andreamazzai/ml/docs/_docs/en/15-clock-en.md

---
title: "Clock"
permalink: en/docs/clock/
excerpt: "Clock Module of the BEAM computer"
---
<small>[Loader and Clock](#loader-and-clock) - [Schematics](#schematics) - [The HLT Instruction](#the-hlt-instruction) - [Useful Links](#useful-links)</small>

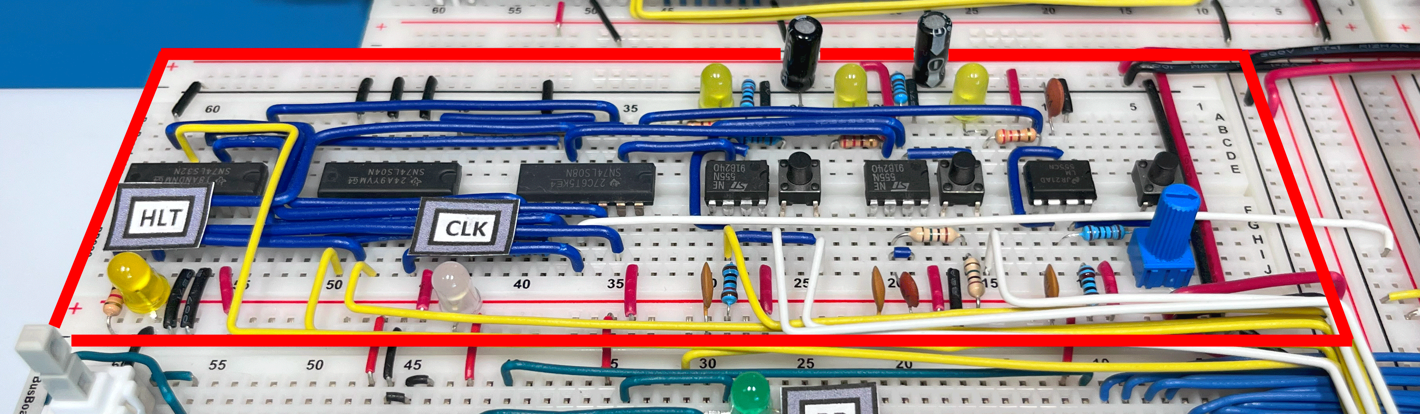
[picture p6: docs/assets/clock/15-beam-clock.png]
BEAM Computer Clock Module


The BEAM computer clock module follows the design created by Ben Eater for the SAP-1 computer, but it uses tactile push buttons instead of slide switches and adds some interaction with external control signals coming from the Loader.

- The first 555 is used as an astable oscillator, with the frequency of operation selectable via a potentiometer. A "Turbo" button temporarily bypasses the potentiometer's resistance, bringing the clock frequency to its maximum value. When running low-speed clock programs for visual analysis of outputs, this button acts like a "Fast Forward."
- The second 555 in monostable mode executes individual micro-operations ("Step").
- The third 555 in bistable mode starts and stops the first 555's clock using a convenient "Start/Stop" button, instead of a switch as in the SAP-1 circuit.

Pressing the Step button during normal operation (astable mode) halts the computer at the current microinstruction and allows proceeding in "Step by Step" mode by repeatedly pressing the same button. Pressing the Start/Stop button resumes normal operation with the astable clock.

The Start/Stop and Step buttons have also been duplicated in a more easily accessible area of the computer, specifically under the Control Logic. In this location, a Reset button has also been included.

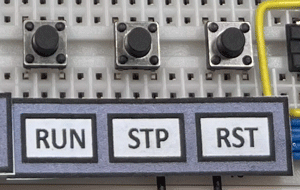
[picture p7: docs/assets/clock/15-run-step-reset.png]
Start/Stop, Step, Reset buttons
[]

### Loader and Clock

On the clock module, there are three signals coming from the [Loader](../en/loader/) based on Arduino: LDR-Active, LDR-CLK, and CLK-Start.

The **LDR-Active** signal, when set to HI, allows the Loader to take control of the clock circuit, completely disabling its output and halting the program execution. In this case, the Loader can inject its clock signal **LDR-CLK** into the computer.

The **CLK-Start** signal is used by the Loader at the end of the programming process to reactivate the clock module and start the freshly loaded program.

## Schematics

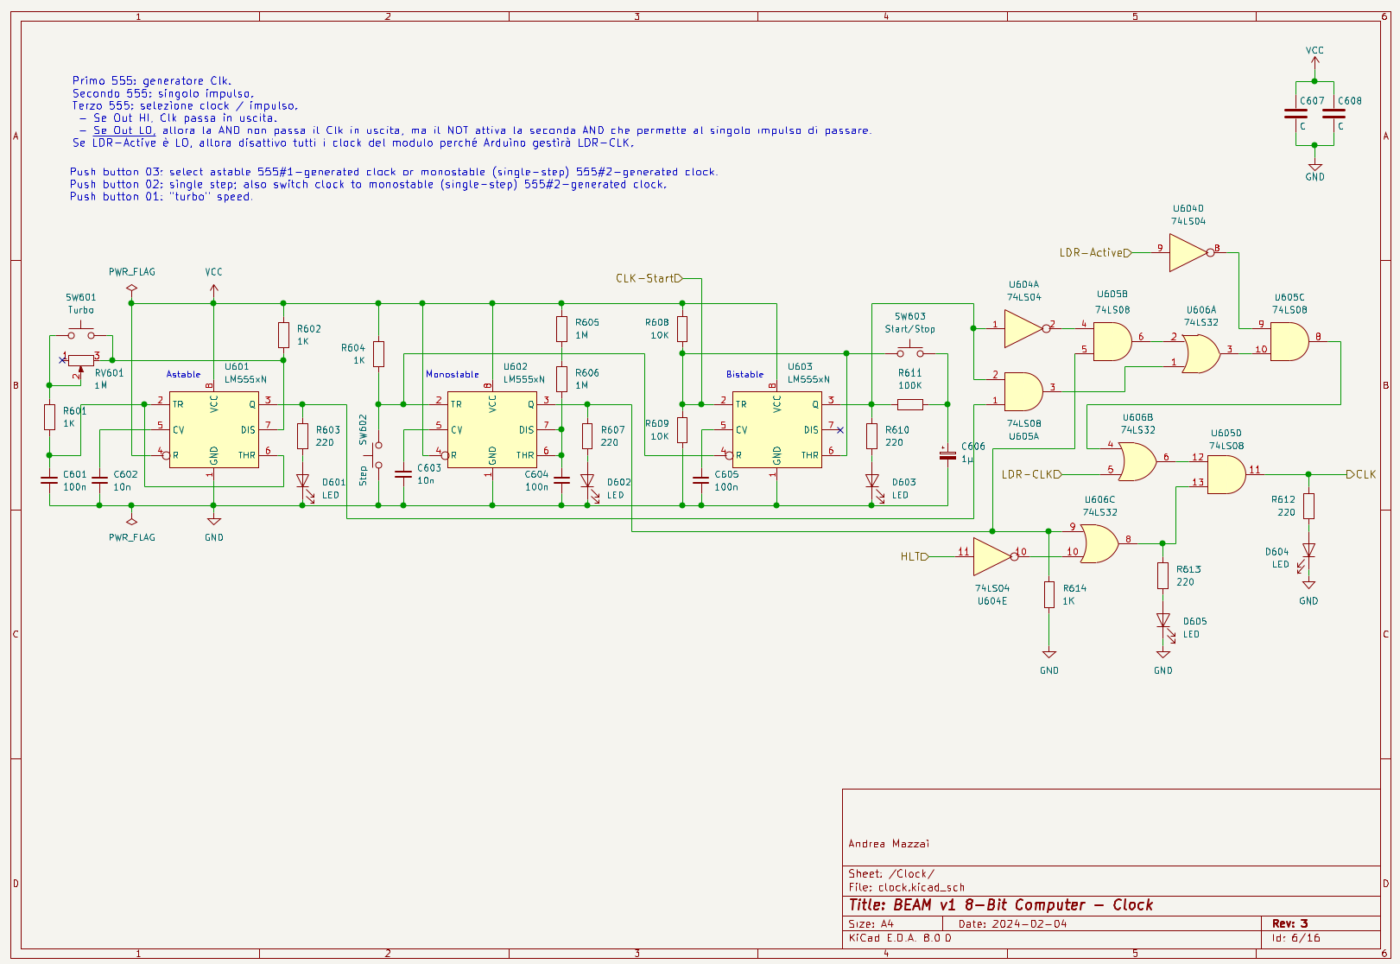
[picture p8: docs/assets/clock/15-clock-schema.png]
Clock Module Schematic


*Clock Module Schematic.*

## The HLT Instruction

The microcode for the HLT instruction activates the corresponding signal on the clock module, halting the execution of the program. To resume operation in continuous clock mode, the current microinstruction must be bypassed by pressing the Step button. At this point, the program execution can be restarted using the Start/Stop button.

## Useful Links

- Ben Eater's <a href="https://eater.net/8bit/clock" target="_blank">videos</a> describing the operation of the 555 timers and the construction of the clock module.
- <a href="https://todbot.com/blog/2010/01/02/momentary-button-as-onoff-toggle-using-555/" target="_blank">A blog</a> explaining how to create a bistable circuit, used here to create the "Start/Stop" function with a button instead of a switch.
