andreamazzai/ml/docs/assets/alu/50-alu-beam-small-top.png

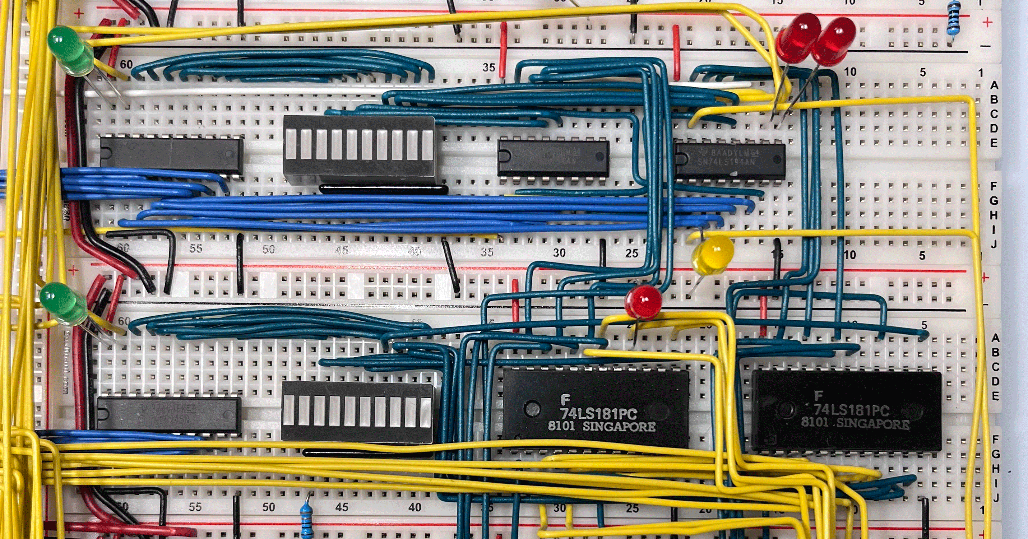
docs/assets/alu/50-alu-beam-small-top.png
