andreamazzai/ml/docs/assets/alu/50-alu-beam-top.png

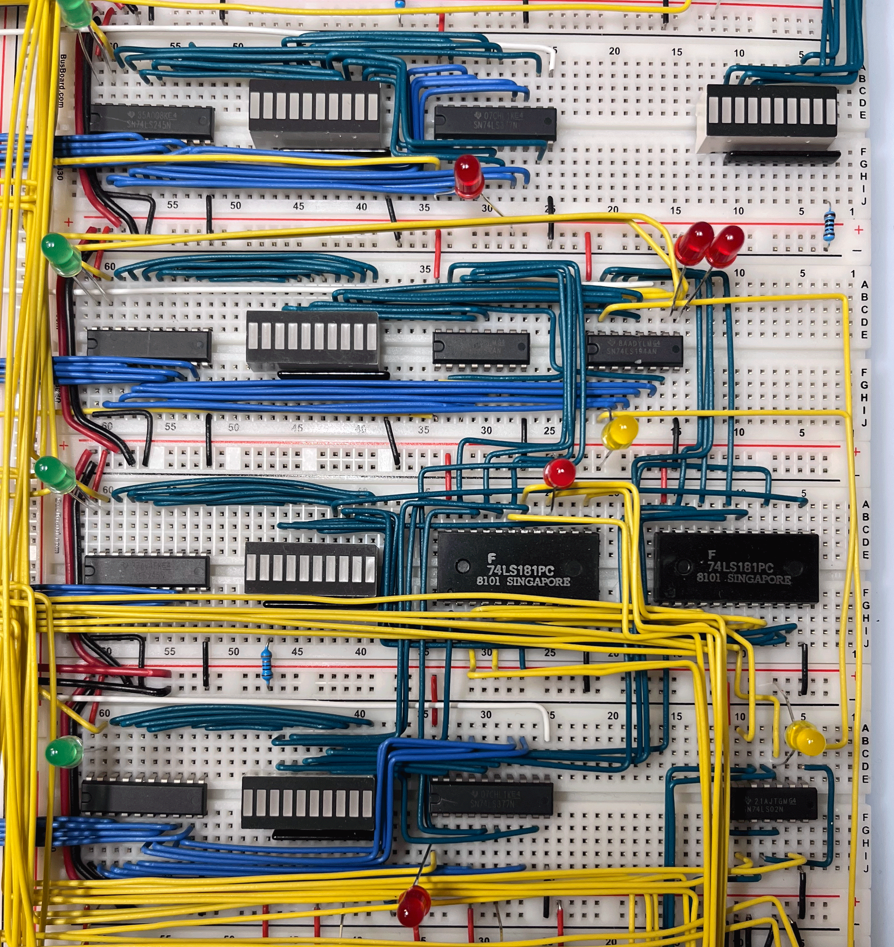
docs/assets/alu/50-alu-beam-top.png
