andreamazzai/ml/docs/assets/control/40-control-logic-161-138-beam.png

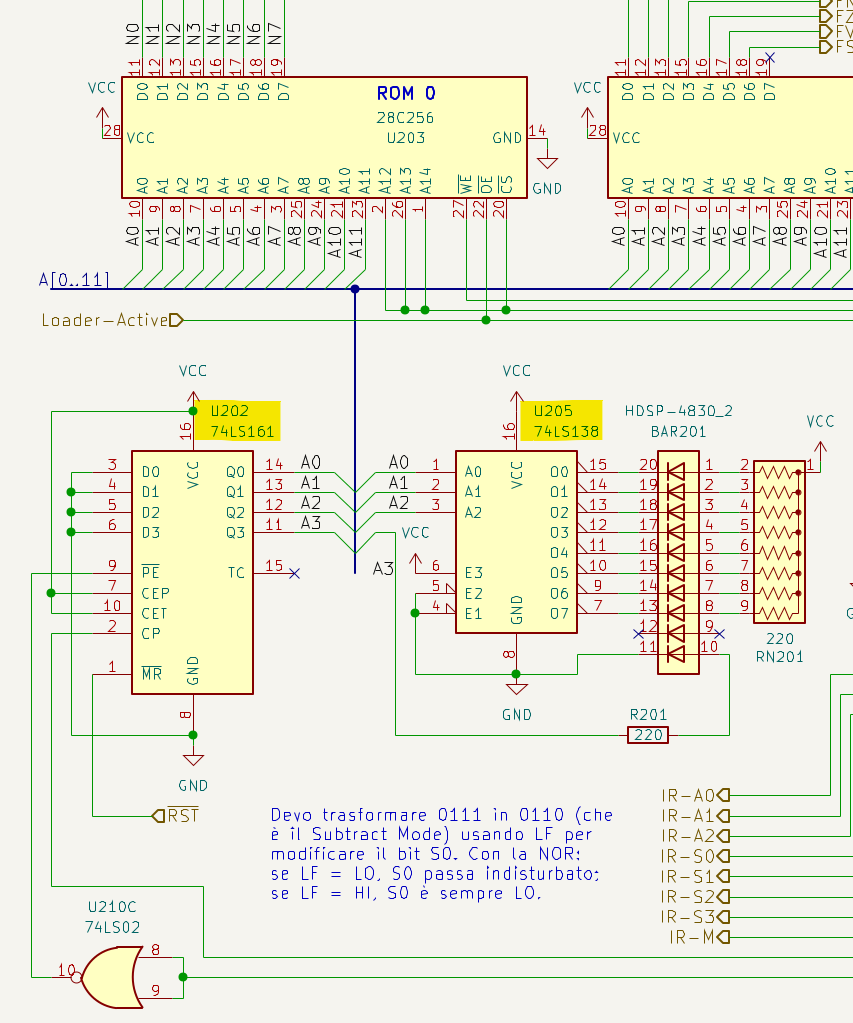
docs/assets/control/40-control-logic-161-138-beam.png
