andreamazzai/ml/docs/assets/control/40-wavedrom-sap-lda-realeold.png

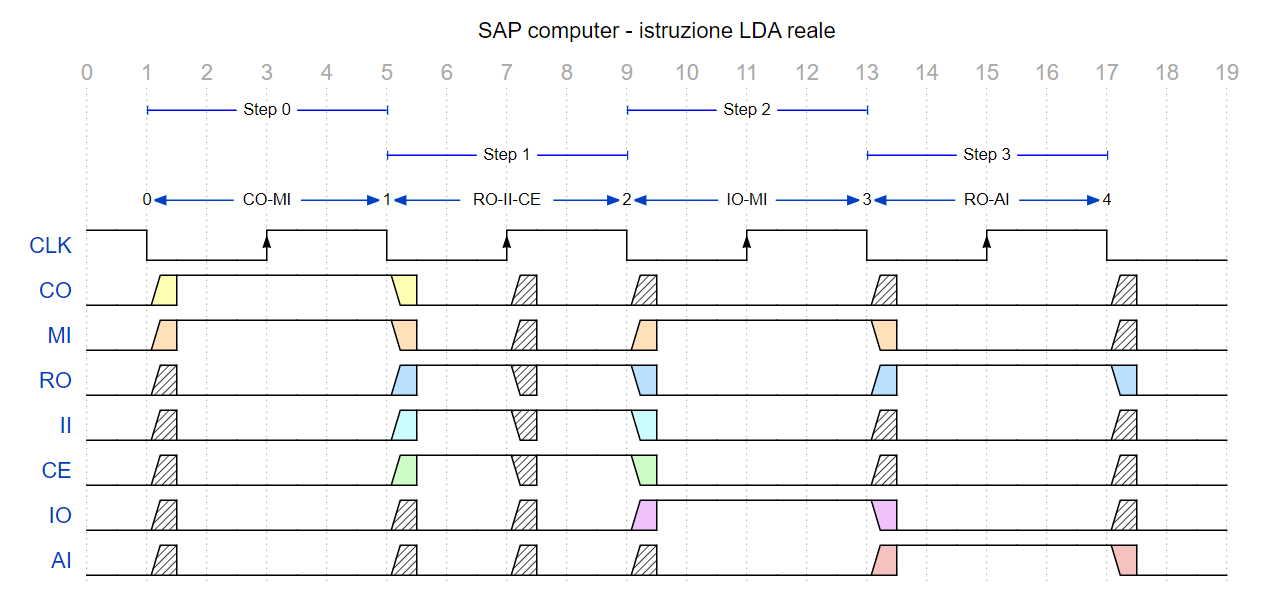
docs/assets/control/40-wavedrom-sap-lda-realeold.png
