andreamazzai/ml/docs/assets/dxy/60-dxy-157-nqsap.png

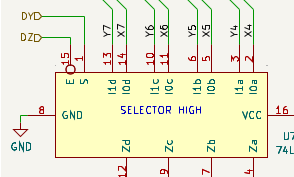
docs/assets/dxy/60-dxy-157-nqsap.png
