andreamazzai/ml/docs/assets/flags/30-flag-beam-top.png

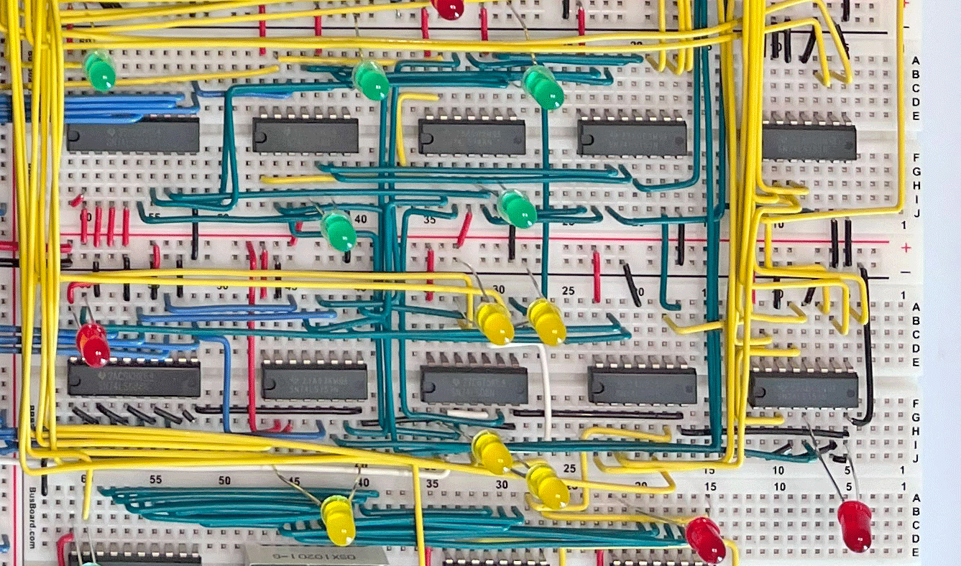
docs/assets/flags/30-flag-beam-top.png
