andreamazzai/ml/docs/assets/flags/30-flag-select-in.png

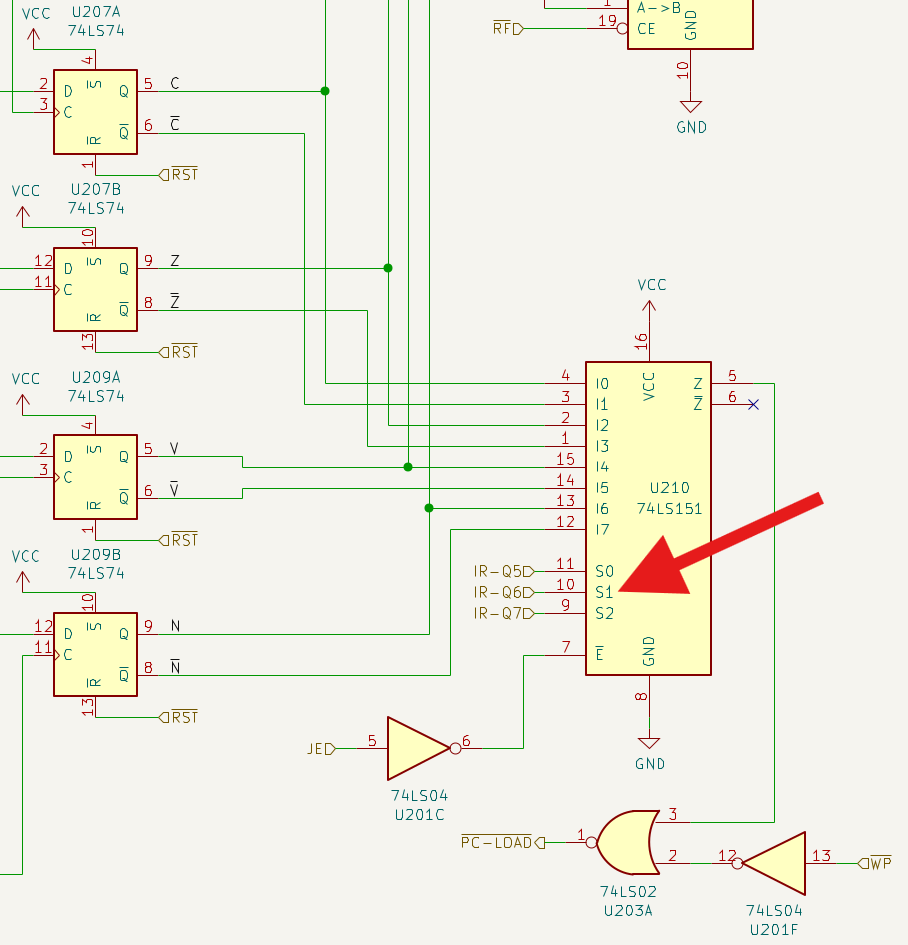
docs/assets/flags/30-flag-select-in.png
