andreamazzai/ml/docs/assets/loader/80-SAP-Loader-Neon.png

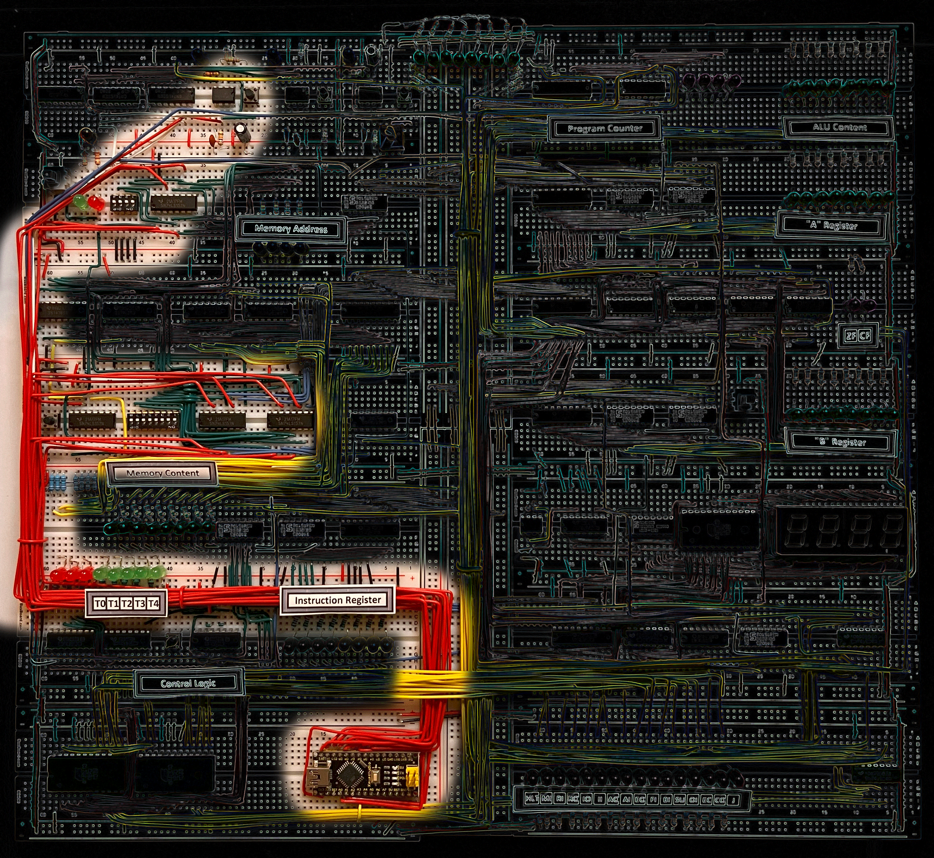
docs/assets/loader/80-SAP-Loader-Neon.png
