andreamazzai/ml/docs/assets/ram/20-be-ram-full.png

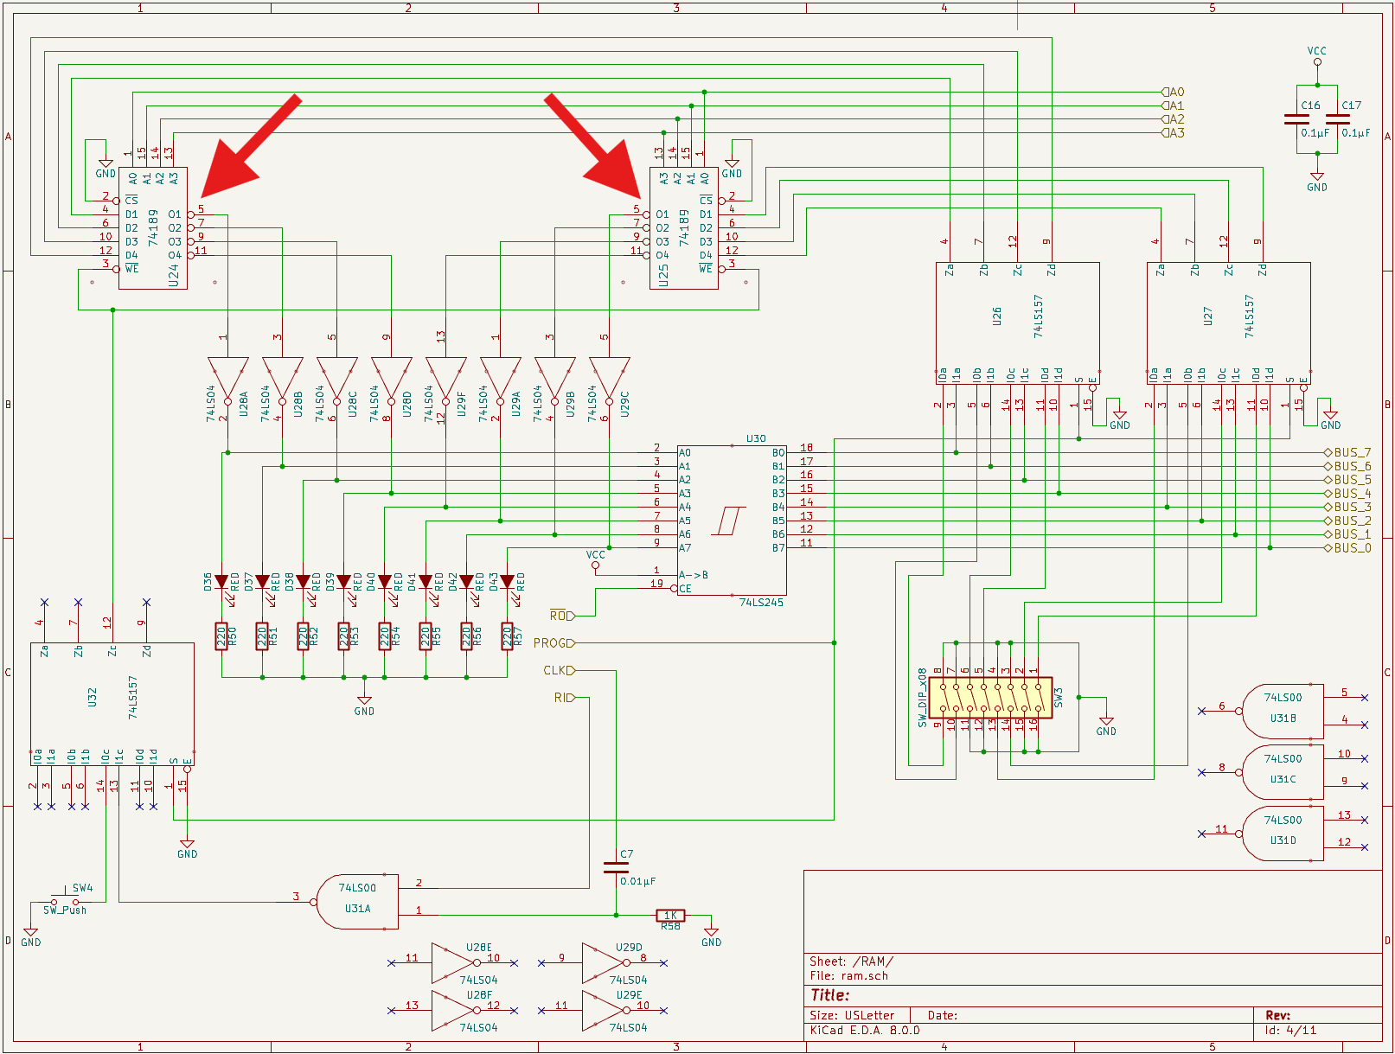
docs/assets/ram/20-be-ram-full.png
