andreamazzai/ml/docs/assets/ram/20-be-ram.png

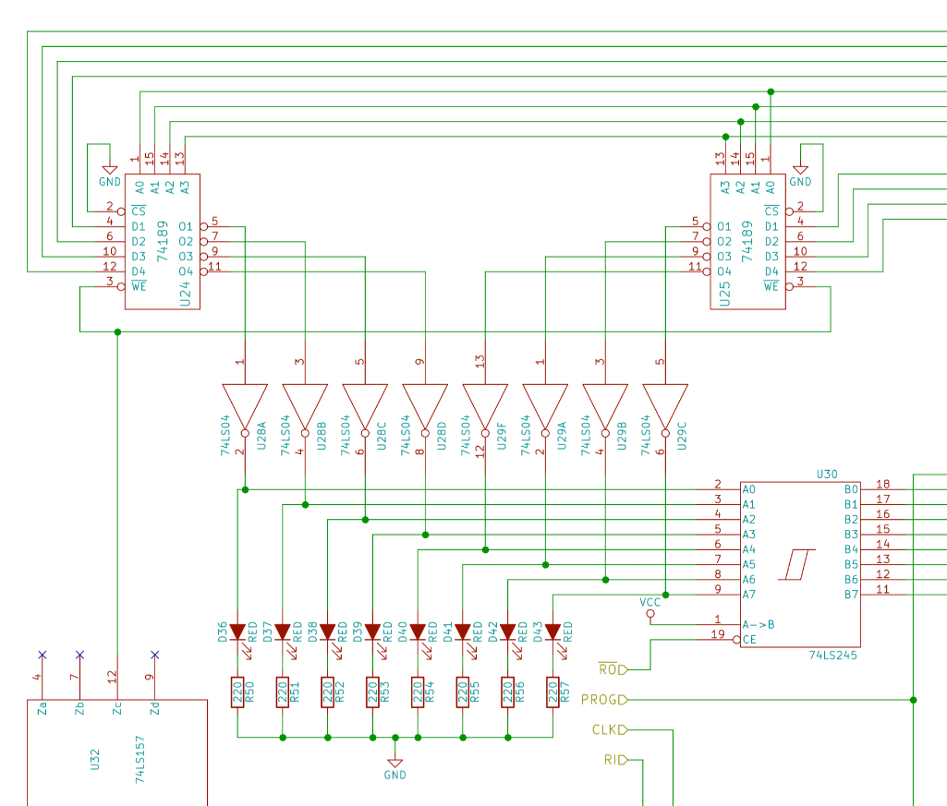
docs/assets/ram/20-be-ram.png
