andreamazzai/ml/docs/assets/ram/20-ram-beam-top.png

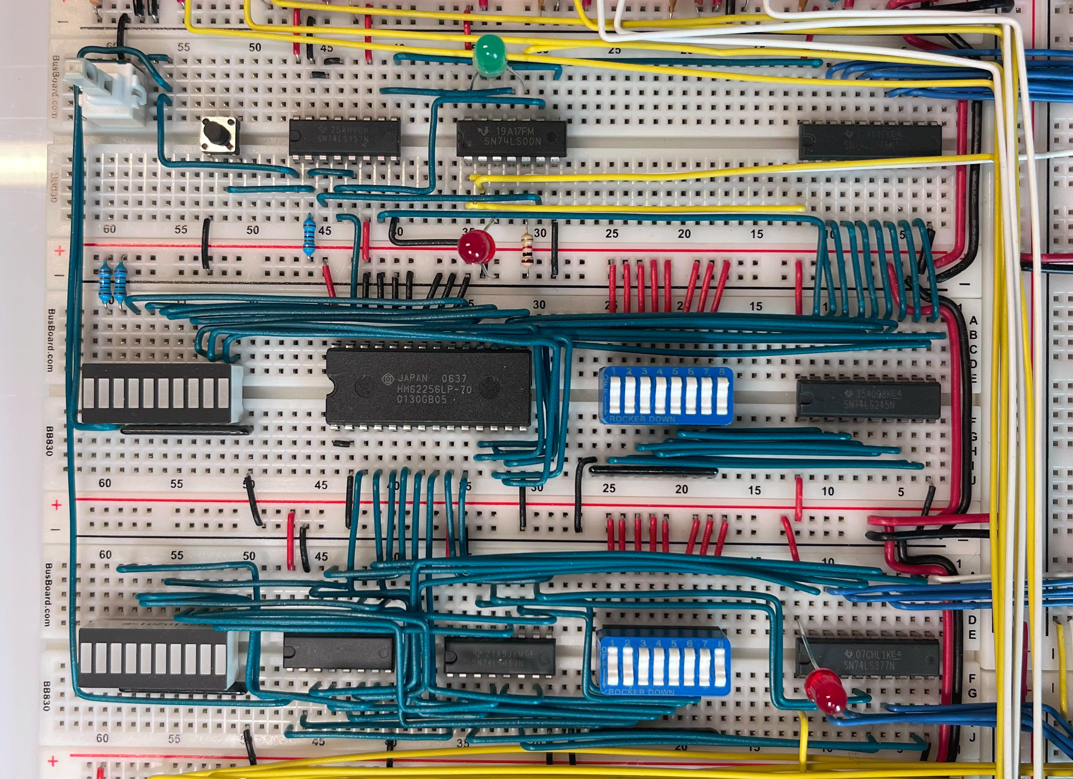
docs/assets/ram/20-ram-beam-top.png
