andreamazzai/ml/docs/assets/sp/70-codice-jsr-tom.png

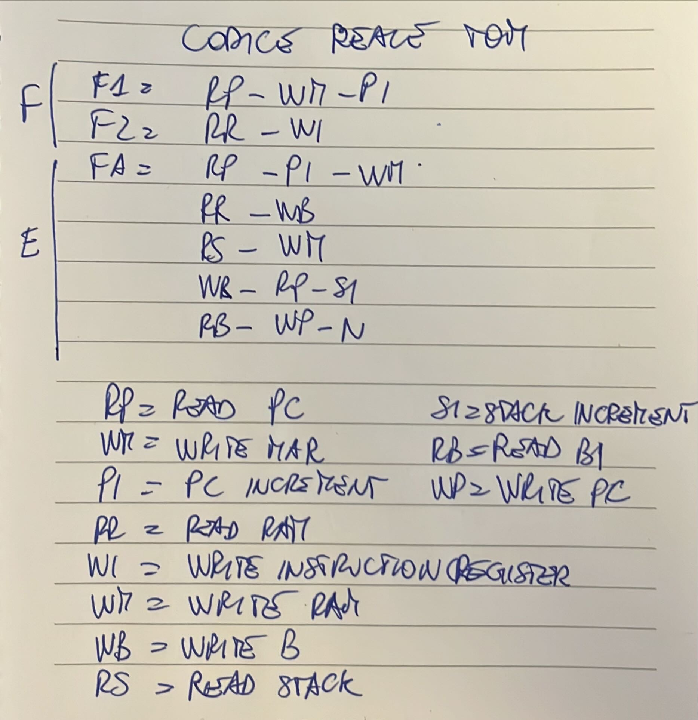
docs/assets/sp/70-codice-jsr-tom.png
