andreamazzai/ml/docs/assets/varie/varie.png

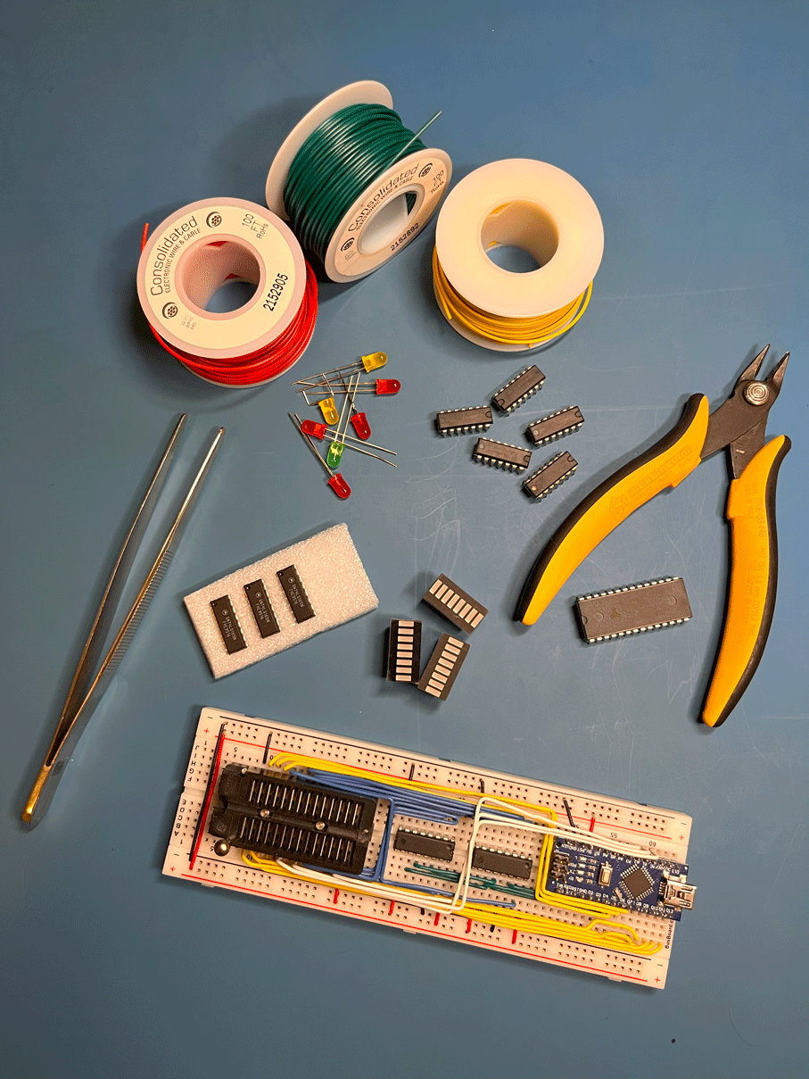
docs/assets/varie/varie.png
