andreamazzai/ml/(commit log)

2024-07-29 poiché la somma di due Signed posit
2024-07-30 il segno del
2024-08-02 Ultimo stadio di un Adder a 8 bit.*
2024-08-03 mma, il valore B7'
2024-08-03 ’ = 1 AND Q7 = 0)
2024-08-09 Schema rivisto con l'applicazione del teorema di De Morgan
2024-08-10 Disegno su carta del modulo RAM e MAR per capire la migliore disposizione dei chip in base ai collegamenti necessari
2024-08-10 Per indirizzare 64K di memoria serve un registro MAR (Memory Address Register) da 16 bit (2^16 = 64K); anziché utilizzare 4 registri a 4 bit 74LS173 (il '173 è il Flip-Flop utilizzato in origine nel 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
2024-08-11 Terza versione del Modulo di memoria (RAM) del BEAM computer
2024-08-11 riprendere la modalità a clock continuo
2024-08-11 NQSAP di Tom Nisbet su GitHub
2024-08-11 SAP di Ben Eater
2024-08-11 • Ring Counter. Vedi spiegazione per resettare in maniera sincrona il 74LS161 sulla pagina dei chip • Praticamente usando il '161: ○ con /CLR, che è asincrono, faccio il
2024-08-12 <a href = "https://us.rs-online.com/product/te-connectivity/5435640-5/70156004/" target = "_blank">materiale elettronico</a>
2024-08-13 Il 9° bit (corrispondente al Carry) non viene preso in considerazione e il rimanente $82 verrà caricato nel PC.
2024-08-13 Questa tecnica funziona correttamente grazie alla natura ciclica dell'indirizzo di memoria in un sistema a 8 bit
2024-08-14 evoluzione dell’NQSAP originale
2024-08-14 definito dalla somma della locazione puntata dall’operando e del valore contenuto in Y
2024-08-14 - e anche La descrizione del salto all'indietro " Il 9° bit (corrispondente al Carry) non viene preso in considerazione e il rimanente $82 verrà caricato nel PC."
2024-08-18 se’ stanti
2024-08-19 ## TO DO
    - /WE ↘↗
    - Descr
2024-08-19 . Il numero di EEPROM dell'NQSAP permette di supportare un numero ben maggiore di segnali di controllo.
2024-08-19 - Evidenziare la nomenclatura dei segnali da fare nella pagina della control logic : l'approcci
2024-08-20 pin di
2024-09-28 Update vari
    [BEAM computer.xlsx]
2024-11-30 con il mieepromcrocode specifico
2024-12-08 Flags updat, schematics upload
